jeanthom/HWFlashTool/docs/KiCAD/HWFlashTool.pdf

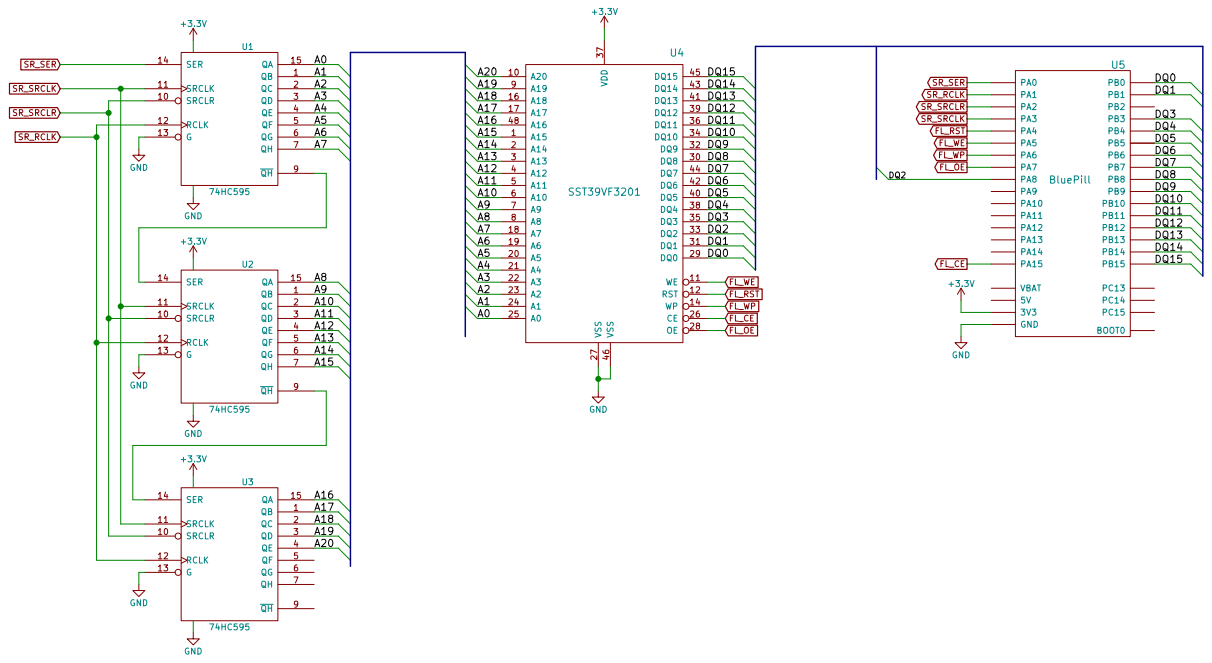
[picture p2: page 1]

Id: 1/1 Title: HWFlashTool File: HWFlashTool.sch Sheet: / Jean THOMAS <git0@pub.jeanthomas.me>
